wizard97/3400_team5electricboogaloo/README.md

Welcome to team 5's 3400 repo!

[Website](https://wizard97.github.io/3400_team5electricboogaloo/)
