wizard97/3400_team5electricboogaloo/docs/Lab2pics/FG output on osc.JPG

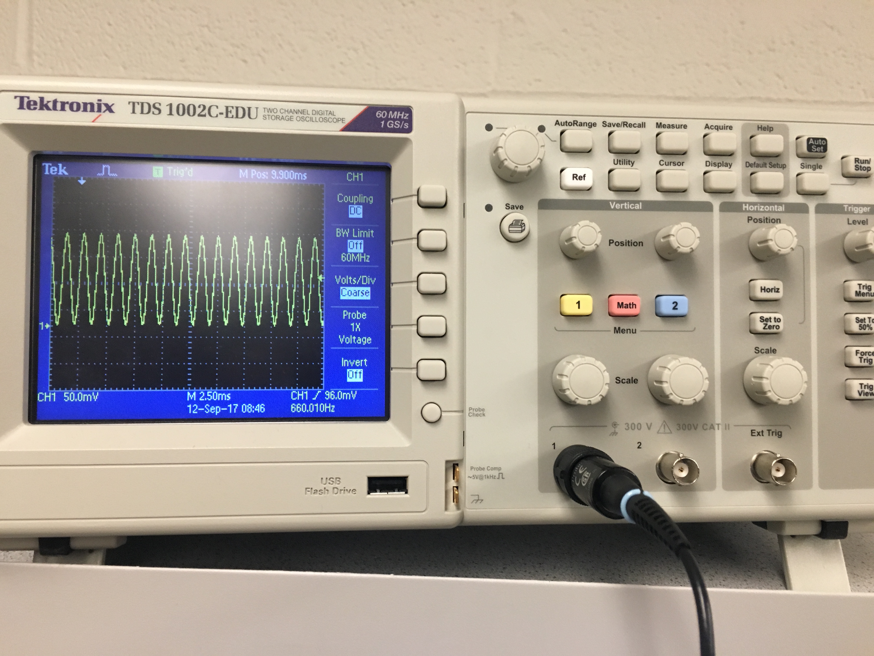
docs/Lab2pics/FG output on osc.JPG
