wizard97/3400_team5electricboogaloo/docs/Lab2pics/function generator.JPG

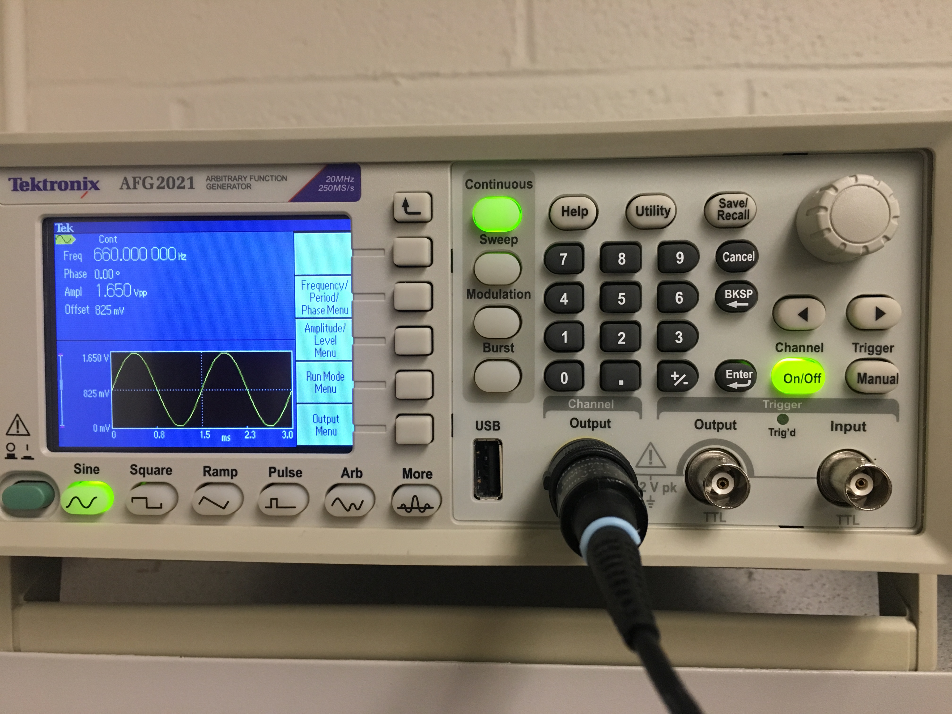
docs/Lab2pics/function generator.JPG
