wizard97/3400_team5electricboogaloo/docs/Lab2pics/Mic_waveform.jpg

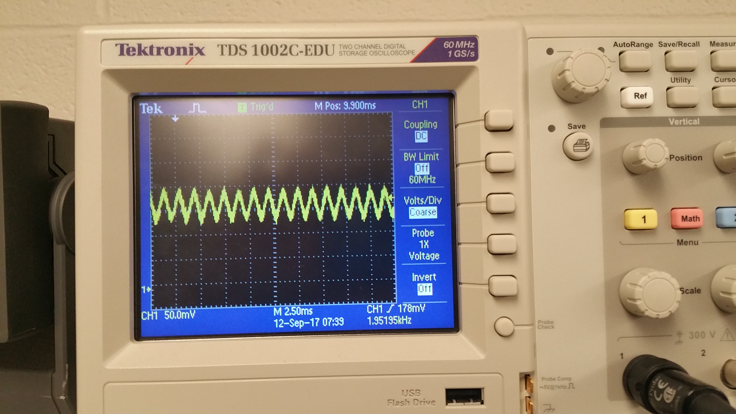
docs/Lab2pics/Mic_waveform.jpg
