wizard97/3400_team5electricboogaloo/docs/Lab2pics/Microphone_circuit.jpg

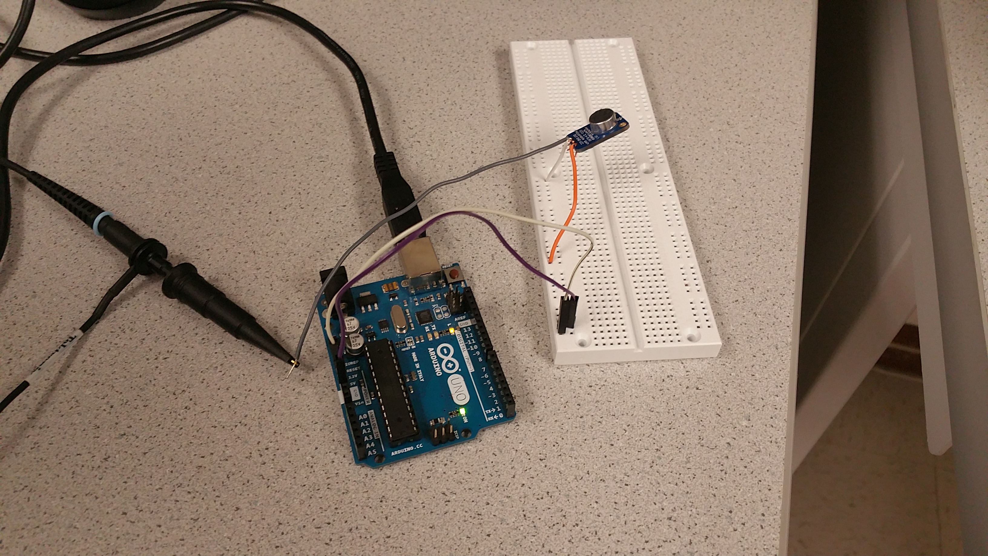
docs/Lab2pics/Microphone_circuit.jpg
