wizard97/3400_team5electricboogaloo/docs/Lab3pics/DAC.png

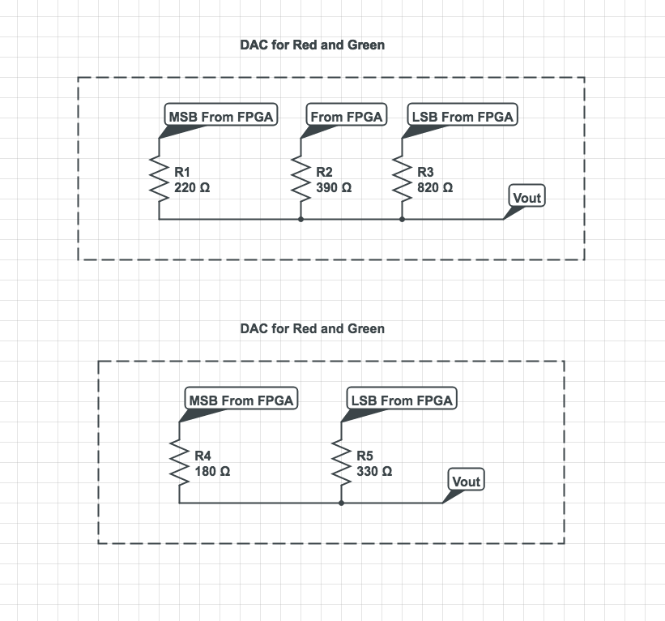
docs/Lab3pics/DAC.png
