wizard97/3400_team5electricboogaloo/docs/Lab3pics/pinconfig.png

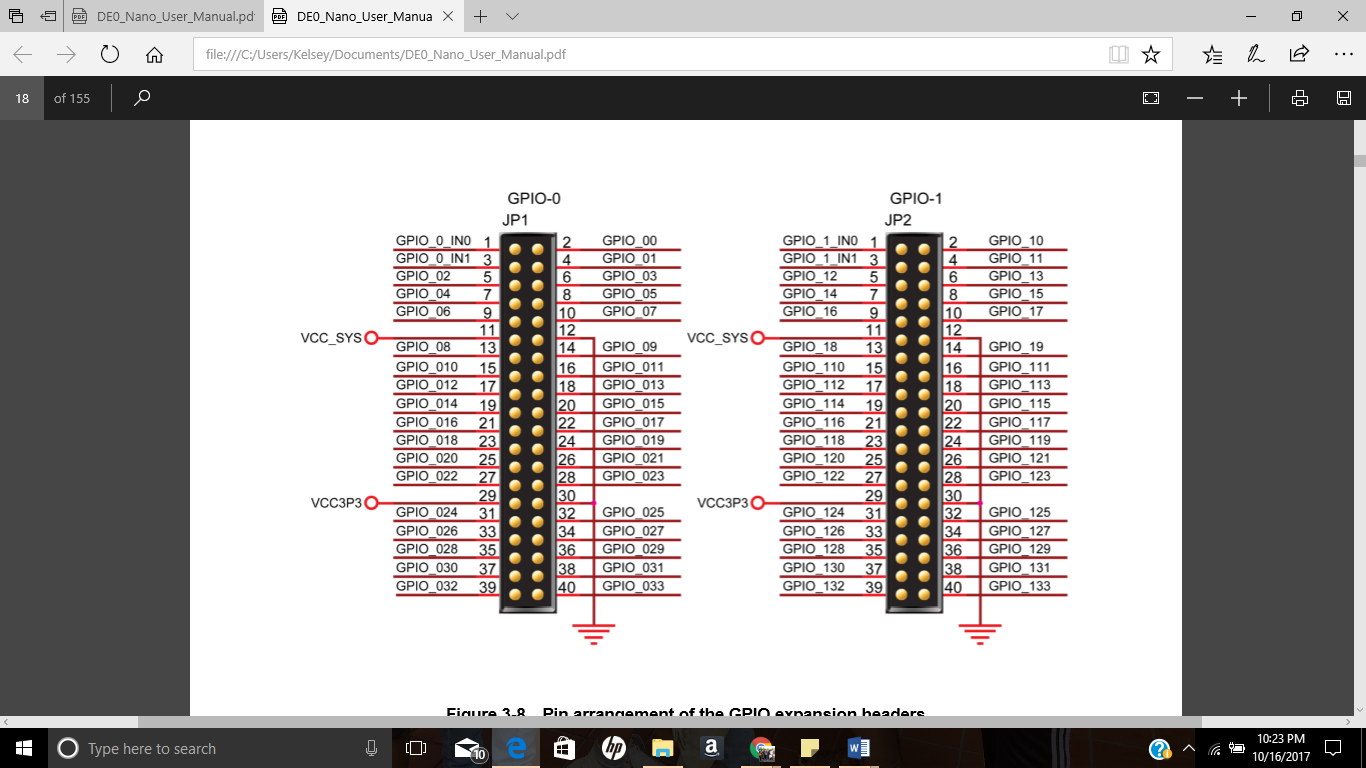
docs/Lab3pics/pinconfig.png
