wizard97/3400_team5electricboogaloo/docs/Lab4pics/code_snippet_maze_creation.jpg

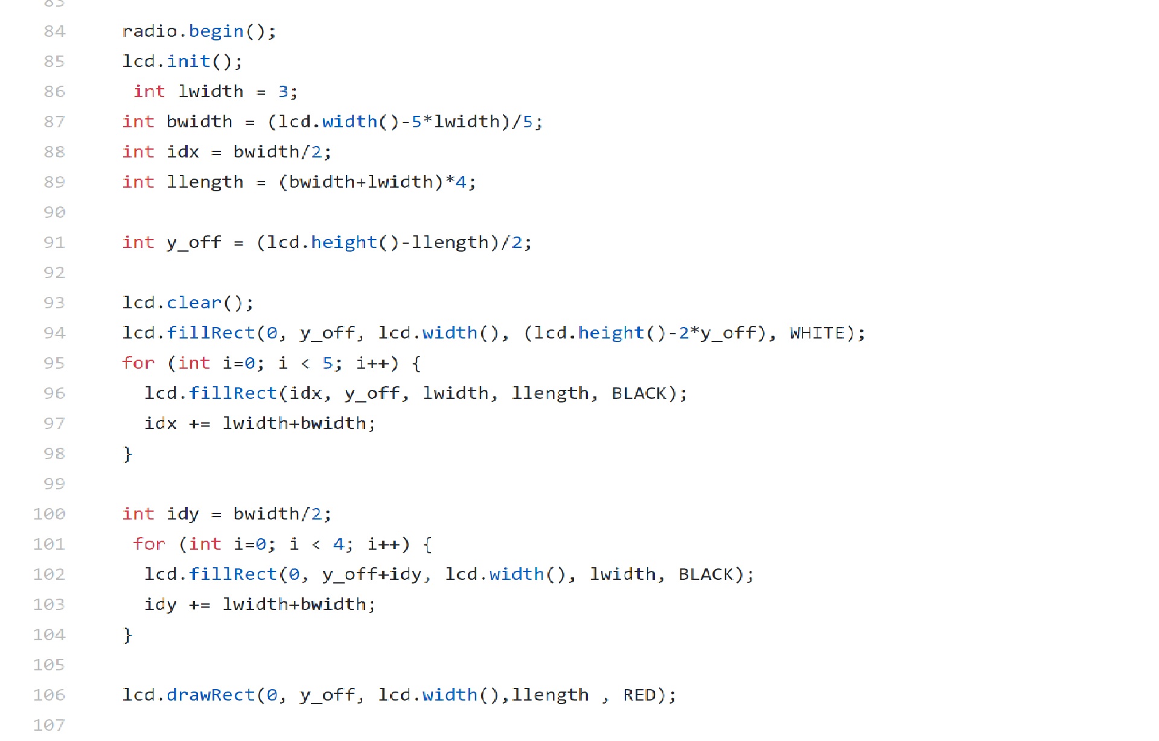
docs/Lab4pics/code_snippet_maze_creation.jpg
