wizard97/3400_team5electricboogaloo/docs/pics/IMG_20170828_201034.jpg

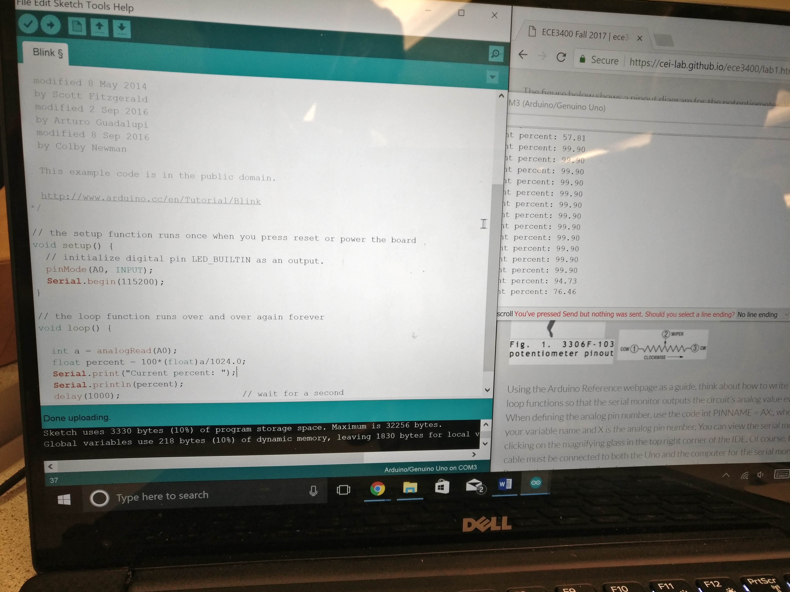
docs/pics/IMG_20170828_201034.jpg
