wizard97/3400_team5electricboogaloo/docs/pics/IMG_20170828_201037.jpg

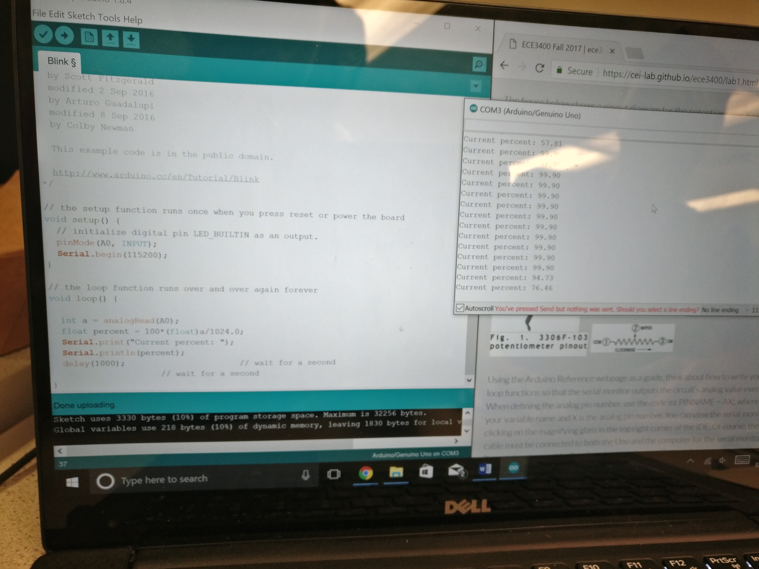
docs/pics/IMG_20170828_201037.jpg
