wizard97/3400_team5electricboogaloo/docs/pics/IMG_20170828_210047.jpg

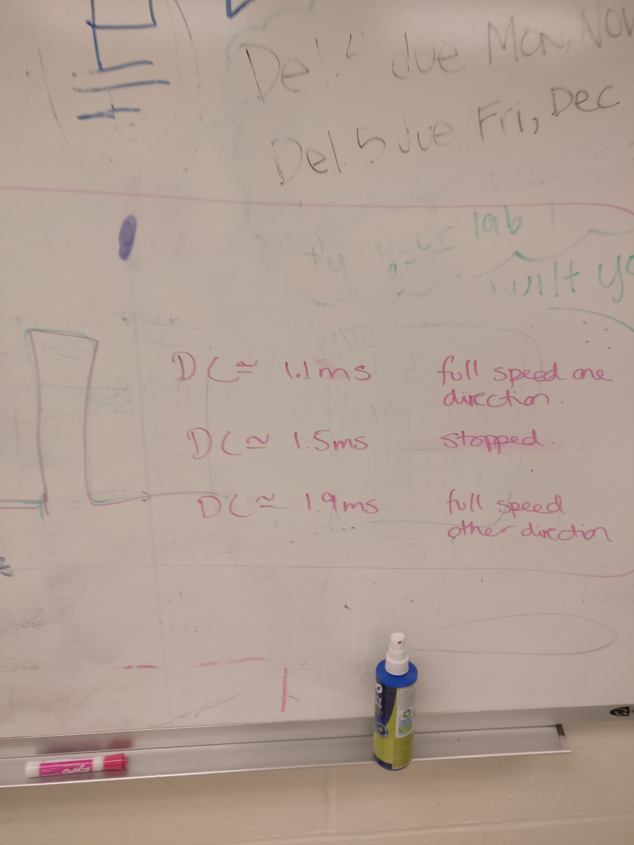
docs/pics/IMG_20170828_210047.jpg
