wizard97/3400_team5electricboogaloo/src/display/khp37-profile.bmp

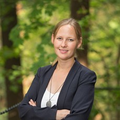
src/display/khp37-profile.bmp
