wizard97/3400_team5electricboogaloo/src/display/khp37-profile_cropped.jpg

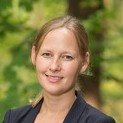
src/display/khp37-profile_cropped.jpg
