wizard97/3400_team5electricboogaloo/src/robot/ir_toggle/ir_toggle.ino

#include <Servo.h>
#include <SPI.h>
#include "enums.h"
#include "nRF24L01.h"
#include "RF24.h"

// Parameters
#define MAX_STACK_SIZE 20
#define X_DIM 4
#define Y_DIM 5

#define LEFT_SERVO 6
#define RIGHT_SERVO 5
#define IN_LEFT_IR A4 
#define IN_RIGHT_IR A1
#define OUT_LEFT_IR A2
#define LINE_THRESHOLD 850 // white = 650, black = 950
#define LINE_FOLLOW_P 2
#define FORWARD_SPEED 10

#define WALL_THRESHOLD 220 
#define FFT_DETECT_THRESH 150

#define MUX_OUT A0
#define MUX_S0 2
#define MUX_S1 3
#define MUX_S2 4

#define POW_SWITCH 7

// IR stuff
#define IR_PIN A5
#define DETECT_THRESH 300 
#define LOG_OUT 1 // use the log output function
#define FFT_N 128 // set to 256 point fft
#define KHZ_7_START 24
#define KHZ_12_START 41
#define KHZ_17_START 58
#define KHZ_RANGE 5
#include <FFT.h>

// Structs
typedef struct Node {
  bool visited; // unvisited = false, visited = true
  int x, y;
  boundary_t left, front, right, negX, posX, negY, posY;
} node_t;

typedef struct Walls {
  bool left_wall, front_wall, right_wall;
} walls_t;

typedef struct DataString {
  unsigned char x, y, next_dir, negX_bound, posX_bound, negY_bound, posY_bound;
  bool treasure7, treasure12, treasure17;
  bool done;
} data_string_t;

// Global variables
node_t grid[Y_DIM][X_DIM];
node_t *visited[MAX_STACK_SIZE] = {NULL};
node_t *frontier[MAX_STACK_SIZE] = {NULL};

state_t state = PASSED_LINE;
state_dir_t dir = POSY;
int x_coord = 0;
int y_coord = -1;
bool done = false;

Servo left_servo, right_servo;

RF24 radio(9,10);

// Radio pipe addresses for the 2 nodes to communicate.
const uint64_t pipes[2] = { 0x0000000010LL, 0x0000000011LL };

// The various roles supported by this sketch
typedef enum { role_ping_out = 1, role_pong_back } role_e;

// The debug-friendly names of those roles
const char* role_friendly_name[] = { "invalid", "Ping out", "Pong back"};

// The role of the current running sketch
role_e role = role_ping_out;

void setup() {
  left_servo.attach(LEFT_SERVO);
  right_servo.attach(RIGHT_SERVO);
  stopMotors();
  pinMode(IN_LEFT_IR, INPUT);
  pinMode(IN_RIGHT_IR, INPUT);
  pinMode(OUT_LEFT_IR, INPUT);
  pinMode(MUX_OUT, INPUT);
  pinMode(MUX_S0, OUTPUT);
  pinMode(MUX_S1, OUTPUT);
  pinMode(MUX_S2, OUTPUT);
  pinMode(POW_SWITCH, OUTPUT);
  digitalWrite(POW_SWITCH, HIGH);

  gridInit();

  Serial.begin(115200);
  radio.begin();
  Serial.println("Radio started");
  delay(10);
  
  radio.setRetries(15,15);
  //radio.setAutoAck(true);
  radio.setChannel(0x50);
  radio.setPALevel(RF24_PA_HIGH);
  radio.setDataRate(RF24_250KBPS);
  radio.setPayloadSize(sizeof(data_string_t));

radio.openWritingPipe(pipes[0]);
radio.openReadingPipe(1,pipes[1]);

  radio.startListening();

  Serial.println("Starting loop");


}


int getMux()
{
  int ret = 0;
  for (int i=0; i < 50; i++) {
    ret += analogRead(MUX_OUT);
    delay(1);
  }
  
  return ret/50;
}

void loop() {
  int ileft_ir = analogRead(IN_LEFT_IR);
  int iright_ir = analogRead(IN_RIGHT_IR);
  int oleft_ir = analogRead(OUT_LEFT_IR);
  
  int maxs = map(FORWARD_SPEED, 0, 100, 90, 0);
  int delta_dir = ileft_ir - iright_ir;
  int left = (180-maxs) - delta_dir/LINE_FOLLOW_P;
  int right = (90-maxs) - delta_dir/LINE_FOLLOW_P;
  left = left > 180 ? 180 : (left < 90 ? 90 : left);
  right = right < 0 ? 0 : (right > 90 ? 90 : right); 

  switch(state) {
    case(NO_LINE): default:
      left_servo.write(left);
      right_servo.write(right);

      if(oleft_ir > LINE_THRESHOLD) state = ON_LINE;
      break;

    case(ON_LINE):
      left_servo.write(left);
      right_servo.write(right);
      
      if (oleft_ir < LINE_THRESHOLD) state = PASSED_LINE;
      break;

    case(PASSED_LINE):
      x_coord = updateXCoord(dir, x_coord);
      y_coord = updateYCoord(dir, y_coord);
      grid[y_coord][x_coord].visited = true;

      digitalWrite(POW_SWITCH, LOW);
      delay(3);
      digitalWrite(MUX_S2, LOW);
      digitalWrite(MUX_S1, LOW);
      digitalWrite(MUX_S0, LOW);
      
      delay(3);
      int front_dist = getMux();
      digitalWrite(MUX_S2, LOW);
      digitalWrite(MUX_S1, LOW);
      digitalWrite(MUX_S0, HIGH);
      delay(3);
      int left_dist = getMux();
      digitalWrite(MUX_S2, LOW);
      digitalWrite(MUX_S1, HIGH);
      digitalWrite(MUX_S0, LOW);
      delay(3);
      int right_dist = getMux();
      digitalWrite(POW_SWITCH, HIGH);
  
      walls_t walls = checkWalls(front_dist, left_dist, right_dist);
      state_dir_t left_dir, right_dir;
      int front_x = -1;
      int front_y = -1;
      int left_x = -1;
      int left_y = -1;
      int right_x = -1;
      int right_y = -1;
      if(!walls.right_wall) {
        grid[y_coord][x_coord].right = NOTHING;
        right_dir = (state_dir_t) ((dir + 1)%4);
        right_x = updateXCoord(right_dir, x_coord);
        right_y = updateYCoord(right_dir, y_coord);
        if(checkOpen(right_x, right_y)) pushStack(&grid[right_y][right_x], frontier);
      } else {
        grid[y_coord][x_coord].right = WALL;
      } if(!walls.left_wall) {
        grid[y_coord][x_coord].left = NOTHING;
        left_dir = (state_dir_t) ((dir + 3)%4);
        left_x = updateXCoord(left_dir, x_coord);
        left_y = updateYCoord(left_dir, y_coord);
        if(checkOpen(left_x, left_y)) pushStack(&grid[left_y][left_x], frontier);
      } else {
        grid[y_coord][x_coord].left = WALL;
      } if(!walls.front_wall) {
        grid[y_coord][x_coord].front = NOTHING;
        front_x = updateXCoord(dir, x_coord);
        front_y = updateYCoord(dir, y_coord);
        if(checkOpen(front_x, front_y)) pushStack(&grid[front_y][front_x], frontier);
      } else {
        grid[y_coord][x_coord].front = WALL;
      }

      gridUpdate(x_coord, y_coord, dir);

      node_t *popped_frontier = popStack(frontier);
      while(popped_frontier->visited) {
        popped_frontier = popStack(frontier);
      }
      if(popped_frontier == NULL) {
        stopMotors();
        done = true;
        transmit(x_coord, y_coord, dir, done);
        Serial.println("Done");
        while(1);
      } else {
        if(front_x == popped_frontier->x && front_y == popped_frontier->y) {
          pushStack(&grid[y_coord][x_coord], visited);
        } else if(left_x == popped_frontier->x && left_y == popped_frontier->y) {
          pushStack(&grid[y_coord][x_coord], visited);
          turnLeft();
        } else if(right_x == popped_frontier->x && right_y == popped_frontier->y) {
          pushStack(&grid[y_coord][x_coord], visited);
          turnRight();
        } else {
          pushStack(popped_frontier, frontier);
          node_t *popped_visited = popStack(visited);
          left_dir = (state_dir_t) ((dir + 3)%4);
          left_x = updateXCoord(left_dir, x_coord);
          left_y = updateYCoord(left_dir, y_coord);
          right_dir = (state_dir_t) ((dir + 1)%4);
          right_x = updateXCoord(right_dir, x_coord);
          right_y = updateYCoord(right_dir, y_coord);
          state_dir_t back_dir = (state_dir_t) ((dir + 2)%4);
          int back_x = updateXCoord(back_dir, x_coord);
          int back_y = updateYCoord(back_dir, y_coord);
          if(left_x == popped_visited->x && left_y == popped_visited->y) turnLeft();
          if(right_x == popped_visited->x && right_y == popped_visited->y) turnRight();
          if(back_x == popped_visited->x && back_y == popped_visited->y) reverse();
        }
      }
      stopMotors();
      transmit(x_coord, y_coord, dir, done);
      Serial.println("testin123");
      state = NO_LINE;
      break;
  } 
}

// Radio helper functions
void transmit(int x, int y, state_dir_t next_dir, bool done) {
  data_string_t data;
      data.treasure17 = 0;
    data.treasure12 = 0;
    data.treasure7 = 0;
  digitalWrite(POW_SWITCH, HIGH);
  unsigned long freq = getFreq();
  if (freq) {
    Serial.print("Detection! freq: ");
    Serial.println(freq);
    
    if (freq == 17) {
      data.treasure17 = true;
    } else if (freq == 12) {
      data.treasure12 = true;
    } else {
      data.treasure7 = true;
    }

    
  } else {
    Serial.println("No detection!");
  }
  
  if(role == role_ping_out) {
    radio.stopListening();

    data.x = x;
    data.y = y;
    data.next_dir = next_dir;
    data.negX_bound = grid[y][x].negX;
    data.posX_bound = grid[y][x].posX;
    data.negY_bound = grid[y][x].negY;
    data.posY_bound = grid[y][x].posY;
    data.done = done;

    Serial.print("Now sending position and state data.\n");
    bool ok = radio.write( &data, sizeof(data) );

    if(ok) {
      Serial.print("ok...sent payload %d, suck it trebek ");
    } else Serial.print("failed.\n\r");

    radio.startListening();
  }
  delay(1);
}

// Setup helper functions
void gridInit() {
  for (int i = 0; i < Y_DIM; i++) {
    for (int j = 0; j < X_DIM; j++) {
      grid[i][j].visited = false;
      grid[i][j].x = j;
      grid[i][j].y = i;
      grid[i][j].left = UNKNOWN;
      grid[i][j].front = UNKNOWN;
      grid[i][j].right = UNKNOWN;
    }
  }
}

void gridUpdate(int x, int y, state_dir_t dir) {
  switch(dir) {
    case(NEGX): default:
      grid[y][x].negX = grid[y][x].front;
      grid[y][x].negY = grid[y][x].right;
      grid[y][x].posY = grid[y][x].left;
      break;
    case(POSX):
      grid[y][x].posX = grid[y][x].front;
      grid[y][x].negY = grid[y][x].left;
      grid[y][x].posY = grid[y][x].right;
      break;
    case(NEGY):
      grid[y][x].negX = grid[y][x].left;
      grid[y][x].posX = grid[y][x].right;
      grid[y][x].negY = grid[y][x].front;
      break;
    case(POSY):
      grid[y][x].negX = grid[y][x].right;
      grid[y][x].posX = grid[y][x].left;
      grid[y][x].posY = grid[y][x].front;
      break;
  }
}

// Stack helper functions
bool pushStack(node_t *n, node_t **stack) {
  for (uint8_t i = 0; i < MAX_STACK_SIZE; i++) {
    if (!stack[i]) {
      stack[i] = n;
      return true;
    }
  } return false;
}

node_t *popStack(node_t **stack) {
  node_t *prev = stack[0];
  for (uint8_t i = 1; i < MAX_STACK_SIZE; i++) {
    if (!stack[i]) {
      stack[i-1] = NULL;
      return prev;
    }
    prev = stack[i];
  } return prev;
}

// Robot helper functions
void turnLeft() {
  int speed = 50;
  int val = map(speed, 0, 100, 90, 0);
  left_servo.write(val);
  right_servo.write(val);
  delay(200);
  while(analogRead(IN_LEFT_IR) < LINE_THRESHOLD || analogRead(IN_RIGHT_IR) < LINE_THRESHOLD);
  dir = updateDir(dir, 0);
}

void turnRight() {
  int speed = 50;
  int val = map(speed, 0, 100, 90, 180);
  left_servo.write(val);
  right_servo.write(val);
  delay(200);
  while(analogRead(IN_LEFT_IR) < LINE_THRESHOLD || analogRead(IN_RIGHT_IR) < LINE_THRESHOLD);
  dir = updateDir(dir, 2);
}

void reverse() {
  int speed = 50;
  int val = map(speed, 0, 100, 90, 180);
  left_servo.write(val);
  right_servo.write(val);
  delay(1000);
  while(analogRead(IN_LEFT_IR) < LINE_THRESHOLD || analogRead(IN_RIGHT_IR) < LINE_THRESHOLD);
  dir = updateDir(dir, 2);
  dir = updateDir(dir, 2);
}

void stopMotors() {
  left_servo.write(90);
  right_servo.write(90);
}

// Helper functions to update position and orientation
int updateXCoord(state_dir_t dir, int x) {
  switch(dir) {
    case(NEGX): default:
      return (x-1);
      break;
    case(POSX):
      return (x+1);
      break;
    case(NEGY):
      return x;
      break;
    case(POSY):
      return x;
      break;
  }
}

int updateYCoord(state_dir_t dir, int y) {
  switch(dir) {
    case(NEGX): default:
      return y;
      break;
    case(POSX):
      return y;
      break;
    case(NEGY):
      return (y-1);
      break;
    case(POSY):
      return (y+1);
      break;
  }
}

state_dir_t updateDir(state_dir_t dir, int lfr) { // lfr: 0 = left, 1 = front, 2 = right
  switch(dir) {
    case(NEGX): default:
      if(lfr == 2) return NEGY;
      else if(!lfr) return POSY;
      break;
    case(POSX):
      if(lfr == 2) return POSY;
      else if(!lfr) return NEGY;
      break;
    case(NEGY):
      if(lfr == 2) return POSX;
      else if(!lfr) return NEGX;
      break;
    case(POSY):
      if(lfr == 2) return NEGX;
      else if(!lfr) return POSX;
      break;
  }
}

// Helper functions to check walls
walls_t checkWalls(int front_dist, int left_dist, int right_dist) {
  walls_t walls;
  if(front_dist > WALL_THRESHOLD) walls.front_wall = 1;
  else walls.front_wall = 0;
  if(left_dist > WALL_THRESHOLD) walls.left_wall = 1;
  else walls.left_wall = 0;
  if(right_dist > WALL_THRESHOLD) walls.right_wall = 1;
  else walls.right_wall = 0;
  return walls;
}

bool checkOpen(int x, int y) {
  if(x < 0 or x > 3 or y < 0 or  y > 4) return false;
  if(grid[y][x].visited) return false;
  return true;
}

// Helper functions for treasure detection
uint8_t getFreq() {

  digitalWrite(MUX_S2, HIGH);
  digitalWrite(MUX_S1, LOW);
  digitalWrite(MUX_S0, LOW);
  
  int tim_old = TIMSK0;
  int adc_old = ADCSRA;
  int admux_old = ADMUX;
  int didr_old = DIDR0;
  
  TIMSK0 = 0; // turn off timer0 for lower jitter
  ADCSRA = 0xe5; // set the adc to free running mode
  ADMUX = 0x40; // use adc0
  DIDR0 = 0x01; // turn off the digital input for adc0
  
   cli();  // UDRE interrupt slows this way down on arduino1.0
    byte freq = 0;
    byte test = 0;
    for (int i = 0 ; i < 256 ; i += 2) { // save 256 samples
      while(!(ADCSRA & 0x10)); // wait for adc to be ready
      ADCSRA = 0xf5; // restart adc
      byte m = ADCL; // fetch adc data
      byte j = ADCH;
      int k = (j << 8) | m; // form into an int
      k -= 0x0200; // form into a signed int
      k <<= 6; // form into a 16b signed int
      fft_input[i] = k; // put real data into even bins
      fft_input[i+1] = 0; // set odd bins to 0
    }
    fft_window(); // window the data for better frequency response
    fft_reorder(); // reorder the data before doing the fft
    fft_run(); // process the data in the fft
    fft_mag_log(); // take the output of the fft
    sei();

    int khz_7 = fft_log_out[KHZ_7_START]; 
    int khz_12 = fft_log_out[KHZ_12_START]; 
    int khz_17 = fft_log_out[KHZ_17_START];
    /*
    Serial.print("7KHZ: ");
    Serial.println(khz_7);
     Serial.print("12KHZ: ");
    Serial.println(khz_12);
     Serial.print("17KHZ: ");
    Serial.println(khz_17);
    */
  TIMSK0 = tim_old; // turn off timer0 for lower jitter
  ADCSRA = adc_old; // set the adc to free running mode
  ADMUX = admux_old; // use adc0
  DIDR0 = didr_old; 

  /*
    for (byte i = 0 ; i < FFT_N/2 ; i++) { 
      Serial.print(i);
      Serial.print(": ");
      Serial.println(fft_log_out[i]); // send out the data
    }
*/
    if (khz_17 > khz_12 && khz_17 > khz_7 && khz_17 > FFT_DETECT_THRESH) {
      return 17;
    } else if (khz_12 > khz_7 && khz_12 > khz_17 && khz_12 > FFT_DETECT_THRESH) {
      return 12;
    } else if (khz_7 > FFT_DETECT_THRESH){
      return 7;
    }
    
    return 0;
}

unsigned long getAvg() {
  unsigned long ret = 0;
  for (int i = 0; i < 1000; i++) {
    ret += analogRead(IR_PIN);
    delayMicroseconds(100);
  }
  return ret/1000;
}
