wizard97/3400_team5electricboogaloo/src/display/draw_kirstin/draw_kirstin.ino

#include <VGAGraphics.h>
const PROGMEM uint8_t kirstin[] = {0x28,0x28,0x28,0x24,0x24,0x24,0x24,0x24,0x24,0x24,0x24,0x24,0x24,0x24,0x24,0x24,0x24,0x28,0x48,0x48,0x48,0x48,0x4c,0x4c,0x4c,0x4c,0x48,0x48,0x48,0x48,0x48,0x48,0x48,0x48,0x48,0x48,0x48,0x28,0x28,0x48,0x48,0x48,0x48,0x48,0x48,0x48,0x48,0x28,0x28,0x28,0x48,0x48,0x4c,0x4c,0x4c,0x4c,0x4c,0x4c,0x4c,0x48,0x4c,0x4c,0x6c,0x6c,0x6c,0x4c,0x48,0x48,0x48,0x48,0x48,0x24,0x24,0x24,0x24,0x24,0x24,0x24,0x24,0x48,0x48,0x24,0x24,0x24,0x24,0x24,0x24,0x24,0x24,0x48,0x48,0x6c,0x6c,0x70,0x70,0x70,0x6c,0x6c,0x4c,0x4c,0x6c,0x6c,0x4c,0x4c,0x6c,0x6c,0x4c,0x4c,0x4c,0x48,0x48,0x48,0x48,0x48,0x28,0x28,0x48,0x4c,0x4c,0x4c
,0x48,0x28,0x28,0x24,0x24,0x24,0x24,0x24,0x24,0x24,0x24,0x24,0x24,0x24,0x24,0x24,0x28,0x48,0x6c,0x6c,0x6c,0x6c,0x6c,0x6c,0x6c,0x4c,0x4c,0x4c,0x48,0x48,0x48,0x48,0x48,0x48,0x48,0x48,0x48,0x28,0x28,0x28,0x48,0x48,0x48,0x4c,0x6c,0x4c,0x4c,0x4c,0x48,0x48,0x4c,0x6c,0x6c,0x6c,0x6c,0x4c,0x4c,0x4c,0x48,0x48,0x4c,0x4c,0x6c,0x6c,0x4c,0x48,0x48,0x48,0x48,0x48,0x48,0x24,0x24,0x24,0x24,0x24,0x24,0x24,0x24,0x24,0x24,0x24,0x24,0x24,0x24,0x24,0x24,0x24,0x24,0x48,0x4c,0x6c,0x70,0x70,0x70,0x70,0x70,0x6c,0x6c,0x4c,0x4c,0x4c,0x4c,0x4c,0x4c,0x4c,0x6c,0x6c,0x4c,0x48,0x48,0x48,0x48,0x28,0x28,0x28,0x48,0x4c,0x4c,0x4c
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
}

void loop() {
  // put your main code here, to run repeatedly:
  lcd.drawRGB8Bitmap(60, 60, kirstin, 120, 120);
  delay(2000);
  lcd.clear();
  lcd.setCursor(5, 190);
  lcd.setTextColor(random(0, 0xffff)); 
  lcd.setTextSize(2);
  lcd.println("My name is Kirstin!");
  delay(2000);

}
