wizard97/3400_team5electricboogaloo/src/lab3/generate_tune/updated/G4_392_ROM.v

//=======================================================
// ECE3400 Fall 2017
// Lab 3: Template ROM module
//
// Top-level skeleton from Terasic
// Modified by Claire Chen for ECE3400 Fall 2017
//=======================================================

module G4_392_ROM(	
	input [8:0] addr,
	input clk,
	output reg [7:0] q
);

    //=======================================================
    //  REG/WIRE declarations
    //=======================================================
	 reg [7:0] sin[318:0];
	 
	 initial begin
		sin[0]  <= 8'b10000000;
		sin[1]  <= 8'b10000010;
		sin[2]  <= 8'b10000101;
		sin[3]  <= 8'b10000111;
		sin[4]  <= 8'b10001010;
		sin[5]  <= 8'b10001100;
		sin[6]  <= 8'b10001111;
		sin[7]  <= 8'b10010001;
		sin[8]  <= 8'b10010100;
		sin[9]  <= 8'b10010110;
		sin[10] <= 8'b10011000;
		sin[11] <= 8'b10011011;
		sin[12] <= 8'b10011101;
		sin[13] <= 8'b10100000;
		sin[14] <= 8'b10100010;
		sin[15] <= 8'b10100101;
		sin[16] <= 8'b10100111;
		sin[17] <= 8'b10101001;
		sin[18] <= 8'b10101100;
		sin[19] <= 8'b10101110;
		sin[20] <= 8'b10110000;
		sin[21] <= 8'b10110011;
		sin[22] <= 8'b10110101;
		sin[23] <= 8'b10110111;
		sin[24] <= 8'b10111010;
		sin[25] <= 8'b10111100;
		sin[26] <= 8'b10111110;
		sin[27] <= 8'b11000000;
		sin[28] <= 8'b11000010;
		sin[29] <= 8'b11000100;
		sin[30] <= 8'b11000111;
		sin[31] <= 8'b11001001;
		sin[32] <= 8'b11001011;
		sin[33] <= 8'b11001101;
		sin[34] <= 8'b11001111;
		sin[35] <= 8'b11010001;
		sin[36] <= 8'b11010011;
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
		sin[306] <= 8'b01011111;
		sin[307] <= 8'b01100010;
		sin[308] <= 8'b01100100;
		sin[309] <= 8'b01100111;
		sin[310] <= 8'b01101001;
		sin[311] <= 8'b01101100;
		sin[312] <= 8'b01101110;
		sin[313] <= 8'b01110001;
		sin[314] <= 8'b01110011;
		sin[315] <= 8'b01110110;
		sin[316] <= 8'b01111000;
		sin[317] <= 8'b01111011;
		sin[318] <= 8'b01111101;
	 end
	 
    //=======================================================
    //  Structural coding
    //=======================================================
	 always @(posedge clk) begin
		q <= sin[addr];
	 end
	 
endmodule
