wizard97/3400_team5electricboogaloo/src/lab3/generate_tune/A3_220_ROM.v

//=======================================================
// ECE3400 Fall 2017
// Lab 3: Template ROM module
//
// Top-level skeleton from Terasic
// Modified by Claire Chen for ECE3400 Fall 2017
//=======================================================

module A3_220_ROM(	
	input [9:0] addr,
	input clk,
	output reg [7:0] q
);

    //=======================================================
    //  REG/WIRE declarations
    //=======================================================
	 reg [7:0] sin[568:0];
	 
	 initial begin
		sin[0]  <= 8'b10000000;
		sin[1]  <= 8'b10000001;
		sin[2]  <= 8'b10000010;
		sin[3]  <= 8'b10000100;
		sin[4]  <= 8'b10000101;
		sin[5]  <= 8'b10000111;
		sin[6]  <= 8'b10001000;
		sin[7]  <= 8'b10001001;
		sin[8]  <= 8'b10001011;
		sin[9]  <= 8'b10001100;
		sin[10] <= 8'b10001110;
		sin[11] <= 8'b10001111;
		sin[12] <= 8'b10010000;
		sin[13] <= 8'b10010010;
		sin[14] <= 8'b10010011;
		sin[15] <= 8'b10010101;
		sin[16] <= 8'b10010110;
		sin[17] <= 8'b10010111;
		sin[18] <= 8'b10011001;
		sin[19] <= 8'b10011010;
		sin[20] <= 8'b10011011;
		sin[21] <= 8'b10011101;
		sin[22] <= 8'b10011110;
		sin[23] <= 8'b10100000;
		sin[24] <= 8'b10100001;
		sin[25] <= 8'b10100010;
		sin[26] <= 8'b10100100;
		sin[27] <= 8'b10100101;
		sin[28] <= 8'b10100110;
		sin[29] <= 8'b10101000;
		sin[30] <= 8'b10101001;
		sin[31] <= 8'b10101010;
		sin[32] <= 8'b10101100;
		sin[33] <= 8'b10101101;
		sin[34] <= 8'b10101110;
		sin[35] <= 8'b10110000;
		sin[36] <= 8'b10110001;
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
		sin[567] <= 8'b01111110;
		sin[568] <= 8'b01111111;
	 end
	 
    //=======================================================
    //  Structural coding
    //=======================================================
	 always @(posedge clk) begin
		q <= sin[addr];
	 end
	 
endmodule
