wizard97/3400_team5electricboogaloo/src/lab3/generate_tune/D3_146_ROM.v

//=======================================================
// ECE3400 Fall 2017
// Lab 3: Template ROM module
//
// Top-level skeleton from Terasic
// Modified by Claire Chen for ECE3400 Fall 2017
//=======================================================

module D3_146_ROM(	
	input [9:0] addr,
	input clk,
	output reg [7:0] q
);

    //=======================================================
    //  REG/WIRE declarations
    //=======================================================
	 reg [7:0] sin[851:0];
	 
	 initial begin
		sin[0]  <= 8'b10000000;
		sin[1]  <= 8'b10000000;
		sin[2]  <= 8'b10000001;
		sin[3]  <= 8'b10000010;
		sin[4]  <= 8'b10000011;
		sin[5]  <= 8'b10000100;
		sin[6]  <= 8'b10000101;
		sin[7]  <= 8'b10000110;
		sin[8]  <= 8'b10000111;
		sin[9]  <= 8'b10001000;
		sin[10] <= 8'b10001001;
		sin[11] <= 8'b10001010;
		sin[12] <= 8'b10001011;
		sin[13] <= 8'b10001100;
		sin[14] <= 8'b10001101;
		sin[15] <= 8'b10001110;
		sin[16] <= 8'b10001111;
		sin[17] <= 8'b10001111;
		sin[18] <= 8'b10010000;
		sin[19] <= 8'b10010001;
		sin[20] <= 8'b10010010;
		sin[21] <= 8'b10010011;
		sin[22] <= 8'b10010100;
		sin[23] <= 8'b10010101;
		sin[24] <= 8'b10010110;
		sin[25] <= 8'b10010111;
		sin[26] <= 8'b10011000;
		sin[27] <= 8'b10011001;
		sin[28] <= 8'b10011010;
		sin[29] <= 8'b10011011;
		sin[30] <= 8'b10011100;
		sin[31] <= 8'b10011100;
		sin[32] <= 8'b10011101;
		sin[33] <= 8'b10011110;
		sin[34] <= 8'b10011111;
		sin[35] <= 8'b10100000;
		sin[36] <= 8'b10100001;
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
		sin[850] <= 8'b01111110;
		sin[851] <= 8'b01111111;
	 end
	 
    //=======================================================
    //  Structural coding
    //=======================================================
	 always @(posedge clk) begin
		q <= sin[addr];
	 end
	 
endmodule
