wizard97/3400_team5electricboogaloo/src/lab3/generate_tune/B_493_ROM.v

//=======================================================
// ECE3400 Fall 2017
// Lab 3: Template ROM module
//
// Top-level skeleton from Terasic
// Modified by Claire Chen for ECE3400 Fall 2017
//=======================================================

module B_493_ROM(	
	input [9:0] addr,
	input clk,
	output reg [7:0] q
);

    //=======================================================
    //  REG/WIRE declarations
    //=======================================================

	 reg [7:0] sin[562:0];
	 
	 initial begin
		sin[0] <= 8'b10000000;
		sin[1] <= 8'b10000001;
		sin[2] <= 8'b10000010;
		sin[3] <= 8'b10000100;
		sin[4] <= 8'b10000101;
		sin[5] <= 8'b10000111;
		sin[6] <= 8'b10001000;
		sin[7] <= 8'b10001001;
		sin[8] <= 8'b10001011;
		sin[9] <= 8'b10001100;
		sin[10] <= 8'b10001110;
		sin[11] <= 8'b10001111;
		sin[12] <= 8'b10010001;
		sin[13] <= 8'b10010010;
		sin[14] <= 8'b10010011;
		sin[15] <= 8'b10010101;
		sin[16] <= 8'b10010110;
		sin[17] <= 8'b10011000;
		sin[18] <= 8'b10011001;
		sin[19] <= 8'b10011010;
		sin[20] <= 8'b10011100;
		sin[21] <= 8'b10011101;
		sin[22] <= 8'b10011111;
		sin[23] <= 8'b10100000;
		sin[24] <= 8'b10100001;
		sin[25] <= 8'b10100011;
		sin[26] <= 8'b10100100;
		sin[27] <= 8'b10100101;
		sin[28] <= 8'b10100111;
		sin[29] <= 8'b10101000;
		sin[30] <= 8'b10101001;
		sin[31] <= 8'b10101011;
		sin[32] <= 8'b10101100;
		sin[33] <= 8'b10101101;
		sin[34] <= 8'b10101111;
		sin[35] <= 8'b10110000;
		sin[36] <= 8'b10110001;
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
		sin[528] <= 8'b01010000;
		sin[529] <= 8'b01010001;
		sin[530] <= 8'b01010010;
		sin[531] <= 8'b01010100;
		sin[532] <= 8'b01010101;
		sin[533] <= 8'b01010110;
		sin[534] <= 8'b01011000;
		sin[535] <= 8'b01011001;
		sin[536] <= 8'b01011010;
		sin[537] <= 8'b01011100;
		sin[538] <= 8'b01011101;
		sin[539] <= 8'b01011110;
		sin[540] <= 8'b01100000;
		sin[541] <= 8'b01100001;
		sin[542] <= 8'b01100011;
		sin[543] <= 8'b01100100;
		sin[544] <= 8'b01100101;
		sin[545] <= 8'b01100111;
		sin[546] <= 8'b01101000;
		sin[547] <= 8'b01101010;
		sin[548] <= 8'b01101011;
		sin[549] <= 8'b01101100;
		sin[550] <= 8'b01101110;
		sin[551] <= 8'b01101111;
		sin[552] <= 8'b01110001;
		sin[553] <= 8'b01110010;
		sin[554] <= 8'b01110011;
		sin[555] <= 8'b01110101;
		sin[556] <= 8'b01110110;
		sin[557] <= 8'b01111000;
		sin[558] <= 8'b01111001;
		sin[559] <= 8'b01111011;
		sin[560] <= 8'b01111100;
		sin[561] <= 8'b01111101;
		sin[562] <= 8'b01111111;
	 end
	 
    //=======================================================
    //  Structural coding
    //=======================================================
 
	always @ (posedge clk)
	begin
		q <= sin[addr];
	end
	 
endmodule
