wizard97/3400_team5electricboogaloo/src/lab3/generate_tune/CSHARP_554_ROM.v

//=======================================================
// ECE3400 Fall 2017
// Lab 3: Template ROM module
//
// Top-level skeleton from Terasic
// Modified by Claire Chen for ECE3400 Fall 2017
//=======================================================

module CSHARP_554_ROM(	
	input [8:0] addr,
	input clk,
	output reg [7:0] q
);

    //=======================================================
    //  REG/WIRE declarations
    //=======================================================

	 reg [7:0] sin[501:0];
	 
	 initial begin
		sin[0] <= 8'b10000000;
		sin[1] <= 8'b10000001;
		sin[2] <= 8'b10000011;
		sin[3] <= 8'b10000100;
		sin[4] <= 8'b10000110;
		sin[5] <= 8'b10000111;
		sin[6] <= 8'b10001001;
		sin[7] <= 8'b10001011;
		sin[8] <= 8'b10001100;
		sin[9] <= 8'b10001110;
		sin[10] <= 8'b10001111;
		sin[11] <= 8'b10010001;
		sin[12] <= 8'b10010011;
		sin[13] <= 8'b10010100;
		sin[14] <= 8'b10010110;
		sin[15] <= 8'b10010111;
		sin[16] <= 8'b10011001;
		sin[17] <= 8'b10011010;
		sin[18] <= 8'b10011100;
		sin[19] <= 8'b10011110;
		sin[20] <= 8'b10011111;
		sin[21] <= 8'b10100001;
		sin[22] <= 8'b10100010;
		sin[23] <= 8'b10100100;
		sin[24] <= 8'b10100101;
		sin[25] <= 8'b10100111;
		sin[26] <= 8'b10101000;
		sin[27] <= 8'b10101010;
		sin[28] <= 8'b10101011;
		sin[29] <= 8'b10101101;
		sin[30] <= 8'b10101110;
		sin[31] <= 8'b10110000;
		sin[32] <= 8'b10110001;
		sin[33] <= 8'b10110011;
		sin[34] <= 8'b10110100;
		sin[35] <= 8'b10110110;
		sin[36] <= 8'b10110111;
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
		sin[500] <= 8'b01111110;
		sin[501] <= 8'b01111111;
	 end
	 
    //=======================================================
    //  Structural coding
    //=======================================================
 
	always @ (posedge clk)
	begin
		q <= sin[addr];
	end
	 
endmodule
