wizard97/3400_team5electricboogaloo/src/lab3/generate_tune/updated/C5_523_ROM.v

//=======================================================
// ECE3400 Fall 2017
// Lab 3: Template ROM module
//
// Top-level skeleton from Terasic
// Modified by Claire Chen for ECE3400 Fall 2017
//=======================================================

module C5_523_ROM(	
	input [8:0] addr,
	input clk,
	output reg [7:0] q
);

    //=======================================================
    //  REG/WIRE declarations
    //=======================================================
	 reg [7:0] sin[238:0];
	 
	 initial begin
		sin[0]  <= 8'b10000000;
		sin[1]  <= 8'b10000011;
		sin[2]  <= 8'b10000110;
		sin[3]  <= 8'b10001010;
		sin[4]  <= 8'b10001101;
		sin[5]  <= 8'b10010000;
		sin[6]  <= 8'b10010100;
		sin[7]  <= 8'b10010111;
		sin[8]  <= 8'b10011010;
		sin[9]  <= 8'b10011101;
		sin[10] <= 8'b10100001;
		sin[11] <= 8'b10100100;
		sin[12] <= 8'b10100111;
		sin[13] <= 8'b10101010;
		sin[14] <= 8'b10101101;
		sin[15] <= 8'b10110001;
		sin[16] <= 8'b10110100;
		sin[17] <= 8'b10110111;
		sin[18] <= 8'b10111010;
		sin[19] <= 8'b10111101;
		sin[20] <= 8'b11000000;
		sin[21] <= 8'b11000010;
		sin[22] <= 8'b11000101;
		sin[23] <= 8'b11001000;
		sin[24] <= 8'b11001011;
		sin[25] <= 8'b11001101;
		sin[26] <= 8'b11010000;
		sin[27] <= 8'b11010011;
		sin[28] <= 8'b11010101;
		sin[29] <= 8'b11011000;
		sin[30] <= 8'b11011010;
		sin[31] <= 8'b11011100;
		sin[32] <= 8'b11011111;
		sin[33] <= 8'b11100001;
		sin[34] <= 8'b11100011;
		sin[35] <= 8'b11100101;
		sin[36] <= 8'b11100111;
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
		sin[237] <= 8'b01111001;
		sin[238] <= 8'b01111101;
	 end
	 
    //=======================================================
    //  Structural coding
    //=======================================================
	 always @(posedge clk) begin
		q <= sin[addr];
	 end
	 
endmodule
