wizard97/3400_team5electricboogaloo/src/lab3/generate_tune/updated/D5_587_ROM.v

//=======================================================
// ECE3400 Fall 2017
// Lab 3: Template ROM module
//
// Top-level skeleton from Terasic
// Modified by Claire Chen for ECE3400 Fall 2017
//=======================================================

module D5_587_ROM(	
	input [8:0] addr,
	input clk,
	output reg [7:0] q
);

    //=======================================================
    //  REG/WIRE declarations
    //=======================================================
	 reg [7:0] sin[212:0];
	 
	 initial begin
		sin[0]  <= 8'b10000000;
		sin[1]  <= 8'b10000011;
		sin[2]  <= 8'b10000111;
		sin[3]  <= 8'b10001011;
		sin[4]  <= 8'b10001111;
		sin[5]  <= 8'b10010010;
		sin[6]  <= 8'b10010110;
		sin[7]  <= 8'b10011010;
		sin[8]  <= 8'b10011101;
		sin[9]  <= 8'b10100001;
		sin[10] <= 8'b10100101;
		sin[11] <= 8'b10101000;
		sin[12] <= 8'b10101100;
		sin[13] <= 8'b10101111;
		sin[14] <= 8'b10110011;
		sin[15] <= 8'b10110110;
		sin[16] <= 8'b10111010;
		sin[17] <= 8'b10111101;
		sin[18] <= 8'b11000000;
		sin[19] <= 8'b11000011;
		sin[20] <= 8'b11000110;
		sin[21] <= 8'b11001010;
		sin[22] <= 8'b11001101;
		sin[23] <= 8'b11010000;
		sin[24] <= 8'b11010010;
		sin[25] <= 8'b11010101;
		sin[26] <= 8'b11011000;
		sin[27] <= 8'b11011011;
		sin[28] <= 8'b11011101;
		sin[29] <= 8'b11100000;
		sin[30] <= 8'b11100010;
		sin[31] <= 8'b11100101;
		sin[32] <= 8'b11100111;
		sin[33] <= 8'b11101001;
		sin[34] <= 8'b11101011;
		sin[35] <= 8'b11101101;
		sin[36] <= 8'b11101111;
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
		sin[195] <= 8'b00111111;
		sin[196] <= 8'b01000011;
		sin[197] <= 8'b01000110;
		sin[198] <= 8'b01001001;
		sin[199] <= 8'b01001101;
		sin[200] <= 8'b01010000;
		sin[201] <= 8'b01010100;
		sin[202] <= 8'b01010111;
		sin[203] <= 8'b01011011;
		sin[204] <= 8'b01011111;
		sin[205] <= 8'b01100010;
		sin[206] <= 8'b01100110;
		sin[207] <= 8'b01101010;
		sin[208] <= 8'b01101101;
		sin[209] <= 8'b01110001;
		sin[210] <= 8'b01110101;
		sin[211] <= 8'b01111001;
		sin[212] <= 8'b01111100;
	 end
	 
    //=======================================================
    //  Structural coding
    //=======================================================
	 always @(posedge clk) begin
		q <= sin[addr];
	 end
	 
endmodule
