wizard97/3400_team5electricboogaloo/src/lab3/generate_tune/updated/G5_783_ROM.v

//=======================================================
// ECE3400 Fall 2017
// Lab 3: Template ROM module
//
// Top-level skeleton from Terasic
// Modified by Claire Chen for ECE3400 Fall 2017
//=======================================================

module G5_783_ROM(	
	input [8:0] addr,
	input clk,
	output reg [7:0] q
);

    //=======================================================
    //  REG/WIRE declarations
    //=======================================================
	 reg [7:0] sin[159:0];
	 
	 initial begin
		sin[0]  <= 8'b10000000;
		sin[1]  <= 8'b10000101;
		sin[2]  <= 8'b10001010;
		sin[3]  <= 8'b10001111;
		sin[4]  <= 8'b10010100;
		sin[5]  <= 8'b10011000;
		sin[6]  <= 8'b10011101;
		sin[7]  <= 8'b10100010;
		sin[8]  <= 8'b10100111;
		sin[9]  <= 8'b10101100;
		sin[10] <= 8'b10110000;
		sin[11] <= 8'b10110101;
		sin[12] <= 8'b10111010;
		sin[13] <= 8'b10111110;
		sin[14] <= 8'b11000010;
		sin[15] <= 8'b11000111;
		sin[16] <= 8'b11001011;
		sin[17] <= 8'b11001111;
		sin[18] <= 8'b11010011;
		sin[19] <= 8'b11010110;
		sin[20] <= 8'b11011010;
		sin[21] <= 8'b11011101;
		sin[22] <= 8'b11100001;
		sin[23] <= 8'b11100100;
		sin[24] <= 8'b11100111;
		sin[25] <= 8'b11101010;
		sin[26] <= 8'b11101100;
		sin[27] <= 8'b11101111;
		sin[28] <= 8'b11110001;
		sin[29] <= 8'b11110100;
		sin[30] <= 8'b11110101;
		sin[31] <= 8'b11110111;
		sin[32] <= 8'b11111001;
		sin[33] <= 8'b11111010;
		sin[34] <= 8'b11111100;
		sin[35] <= 8'b11111101;
		sin[36] <= 8'b11111110;
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
		sin[158] <= 8'b01111000;
		sin[159] <= 8'b01111101;
	 end
	 
    //=======================================================
    //  Structural coding
    //=======================================================
	 always @(posedge clk) begin
		q <= sin[addr];
	 end
	 
endmodule
