wizard97/3400_team5electricboogaloo/(commit log)

2017-09-18 adding microphone stuff
    i will go in tomorrow for a couple pictures and a little more testing
2017-09-19 PID line control
2017-09-26 Added filter pic
2017-10-15 64x64 VGA SPI controller
2017-10-15 Added Arduino vga example
2017-10-17 Arduino vga
2017-10-17 Faster SPI transactions, 8MHZ
2017-10-17 Defer initing of spi
2017-10-20 Changed servo pins 9 and 10 to 6 and 7
    We need to use pins 8-13 for the radio sensors, moved servo pins 9&10 to pwm pins 6&7
2017-10-20 made mistake, pins 6&7 no 5&6
    [milestone1.ino]
2017-10-24 Pin 9 instead of 10
