wizard97/3400_team5electricboogaloo/docs/Lab2pics/microphone hookup.JPG

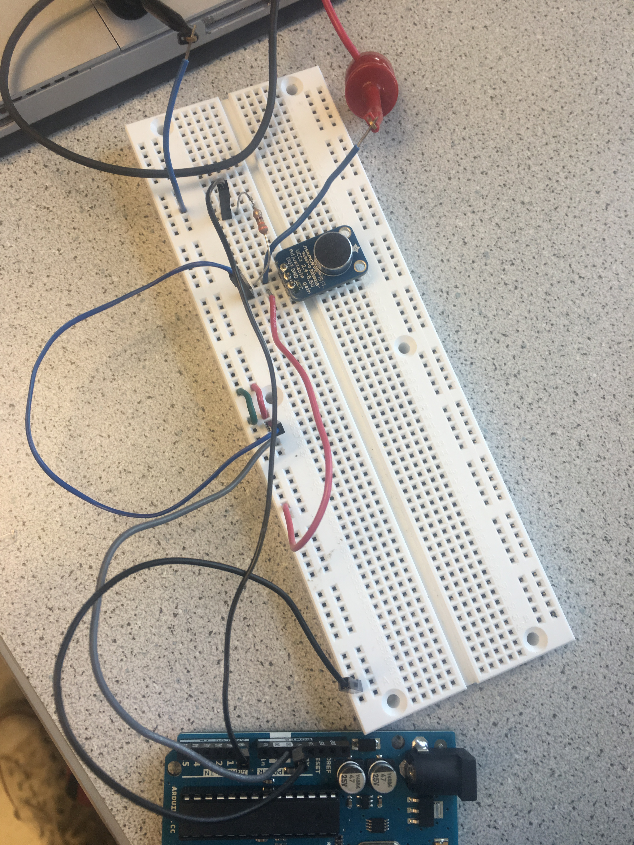
[picture p12: docs/Lab2pics/microphone_hookup.jpg]
docs/Lab2pics/microphone hookup.JPG
