wizard97/3400_team5electricboogaloo/docs/Lab2pics/op amp with microphonr.JPG

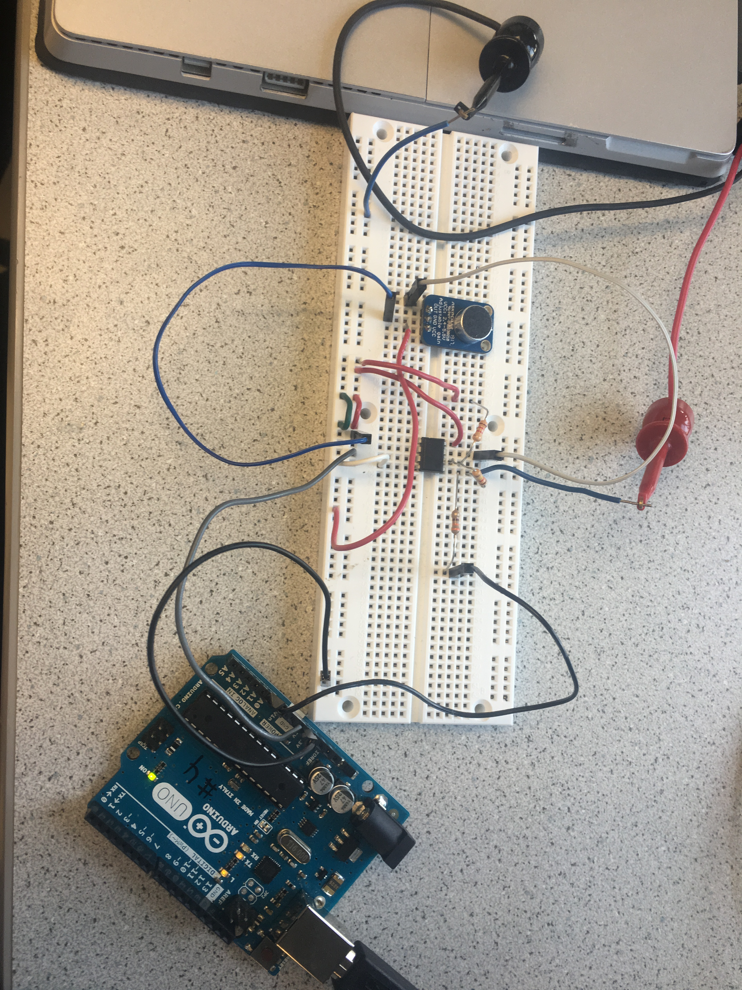
docs/Lab2pics/op amp with microphonr.JPG
